MorskiWloczykij/STM32-DSP/Project Outputs for STM32_DSP/STM32_DSP.xlsx

Name | Description | Designator | Quantity | Manufacturer Part Number | Manufacturer
470p 50V | Capacitor: ceramic; MLCC; 470pF; 50V; X7R; ±10%; SMD; 0805 | C1, C8, C16, C24 | 4 | C0805C471K5RAC | KEMET
10u 25V | Capacitor: ceramic; MLCC; 10uF; 25V; X5R; ±10%; SMD; 0805 | C2, C7, C73, C74, C76, C82, C84, C86, C88, C90, C91, C92, C93 | 13 | GRM21BR61E106KA73K | MURATA
2.7n 50V | Capacitor: ceramic; MLCC; 2.7nF; 50V; X7R; ±10%; SMD; 0805 | C3, C6 | 2 | 08055C272KAT2A | KYOCERA AVX
1u 10V | Capacitor: ceramic; MLCC; 1uF; 10V; X7R; ±10%; SMD; 0805 | C4, C29, C30, C37, C38, C57 | 6 | CC0805KKX7R6BB105 | YAGEO
100n 100V | Capacitor: ceramic; MLCC; 100nF; 100V; X7R; ±10%; SMD; 0805 | C5, C10, C12, C14, C23, C32, C35, C36, C39, C60, C61, C62, C63, C64, C65, C66, C67, C68, C69, C70, C71, C72, C75, C77, C79, C81, C83, C85, C87, C89, C94 | 31 | CC0805KKX7R0BB104 | YAGEO
22u 10V | Capacitor: ceramic; 22uF; 10V; X5R; ±20%; SMD; 0805 | C9, C11, C13, C17, C19, C21, C25, C27, C33, C34, C78, C80 | 12 | CL21A226MPQNNNE | SAMSUNG
2.2n 50V | Capacitor: ceramic; MLCC; 2.2nF; 50V; X7R; ±10%; SMD; 0805 | C15, C22 | 2 | 08055C222KAT2A | KYOCERA AVX
6.8n 50V | Capacitor: ceramic; MLCC; 6.8nF; 50V; X7R; ±10%; SMD; 0805 | C18, C26 | 2 | 08055C682KAT2A | KYOCERA AVX
1.5n 50V | Capacitor: ceramic; MLCC; 1.5nF; 50V; X7R; ±10%; SMD; 0805 | C20, C28 | 2 | 08055C152KAT2A | KYOCERA AVX
20p 50V | Capacitor: ceramic; MLCC; 20pF; 50V; C0G (NP0); ±5%; SMD; 0805 | C40, C41, C42, C43 | 4 | 08055A200JAT2A | KYOCERA AVX
6.8p 50V | Capacitor: ceramic; MLCC; 6.8pF; 50V; C0G (NP0); ±0.25pF; SMD; 0805 | C44, C45 | 2 | CC0805CRNPO96R8 | YAGEO
1u 20V | Capacitor: tantalum; 1uF; 20VDC; SMD; A; 1206; ±10%; -55÷125°C; T491 | C46, C48 | 2 | T491A105K020AT | KEMET
100n 10V | Capacitor: ceramic; MLCC; 100nF; 100V; X7R; ±10%; SMD; 0805 | C47, C49, C50, C51, C52, C53, C54, C55, C56 | 9 | CC0805KKX7R0BB104 | YAGEO
2.2u 10V | Multilayer Ceramic Capacitors MLCC - SMD/SMT 0603 16VDC 1uF 10% X7R | C58, C59 | 2 | CC0805KKX7R6BB225 | YAGEO
3.3V | Diode: TVS; 134W; 5V; 11.2A; unidirectional; SOD523F; reel,tape | D1, D2, D3 | 3 | ESD5Z3V3 | DIOTEC SEMICONDUCTOR
Green |  | D4, D5, D6, D7 | 4 | - | -
12V | Zener Diodes 12 Volt 0.5W 5% | D8 | 1 | BZT55C12 | Vishay Semiconductors
Green | Standard LEDs - SMD WL-SMCW SMDMono TpVw Waterclr 0805 Green | D9 | 1 | 150080GS75000 | Wurth Elektronik
JC-211 | Socket; Jack 6,3mm; female; mono; ways: 2; for panel mounting; THT | J1, J2, J3, J4 | 4 | JC-211 | NINIGI
10 PIN | Pin header; pin strips; male; PIN: 10; straight; 1.27mm; THT; 2x5 | J5 | 1 | DS1031-06-2*5P8BV41-3A | CONNFLY
USB4105 | Socket; USB C; SMT; PIN: 16; horizontal; top board mount; USB 2.0 | J6 | 1 | USB4105-GF-A | GCT
PJ-002A | DC Power Connectors Power Jacks | J7 | 1 | PJ-002A | https://pl.mouser.com/datasheet/2/670/pj_002a-1778764.pdf
2 PIN | Headers & Wire Housings 2.54MM CGRIDIII HDR 2P VERT SR SEL AU | J8 | 1 | 90120-0762 | Molex
2700R | Ferrite: bead; 2700Ω; SMD; 200mA; 0805; -55÷125°C | L1, L4, L5, L6, L7, L8, L9, L10 | 8 | BLM21BD272SN1L | MURATA
150mΩ | Inductor: ferrite; SMD; 0805; 2.2uH; 1A; 150mΩ; 2MHz; ±20%; -40÷125°C | L2, L3 | 2 | MLP2012H2R2MT0S1 | TDK
100k | Trimmer Resistors - Through Hole 1/4"SQ 100KOHMS 10% 0.5WATTS | POT1, POT2 | 2 | 3362P-1-104LF | Bourns
100k | Potentiometers 100K 20% 9MM CARBON POT | POT3, POT4, POT5, POT6, POT7, POT8 | 6 | PTV09A-4020U-B104 | Bourns
1k | Trimmer Resistors - SMD TRIMMER-3MM OPEN FRAME | POT9, POT10 | 2 | TC33X-1-102E | Bourns
560R | Resistor: thick film; SMD; 0805; 560Ω; 0.125W; ±1%; -55÷155°C | R1, R9, R10, R17, R21, R29, R50, R51, R58, R59 | 10 | RC0805FR-07560R | Yageo
33R | Resistor: thick film; SMD; 0805; 33Ω; 0.125W; ±1%; -55÷155°C | R2, R4, R13, R14, R40, R42, R43, R45, R46, R47, R49, R69, R70 | 13 | RC0805FR-0733R | Yageo
100R | Resistor: thick film; SMD; 0805; 100Ω; 0.125W; ±1%; -55÷155°C | R3, R15, R73 | 3 | RC0805FR-07100R | Yageo
2.2M | Resistor: thick film; SMD; 0805; 2.2MΩ; 0.125W; ±5%; -55÷155°C | R5, R11 | 2 | RC0805JR-072M2 | Yageo
10k | Resistor: thick film; SMD; 0805; 10kΩ; 0.125W; ±1%; -55÷155°C | R6, R7, R12, R16, R35, R36, R37, R38, R54, R55, R62, R63, R64, R65, R66, R67, R68 | 17 | RC0805FR-0710K | Yageo
220R | Resistor: thick film; SMD; 0805; 220Ω; 0.125W; ±1%; -55÷155°C | R8 | 1 | RC0805FR-07220R | Yageo
4.7k | Resistor: thick film; SMD; 0805; 4.7kΩ; 0.125W; ±1%; -55÷155°C | R18, R26, R41, R44, R48, R71, R72 | 7 | RC0805FR-074K7 | Yageo
3.9k | Resistor: thick film; SMD; 0805; 3.9kkΩ; 0.125W; ±1%; -55÷155°C | R19, R27 | 2 | RC0805FR-073K9 | Yageo
2.2k | Resistor: thick film; SMD; 0805; 2.2kΩ; 0.125W; ±1%; -55÷155°C | R20, R28, R52, R53, R56, R57, R60, R61 | 8 | RC0805FR-072K2 | Yageo
1.2k | Resistor: thick film; SMD; 0805; 1.2kΩ; 0.125W; ±1%; -55÷155°C | R22, R30 | 2 | RC0805FR-071K2 | Yageo
680R | Resistor: thick film; SMD; 0805; 680Ω; 0.125W; ±1%; -55÷155°C | R23, R31 | 2 | RC0805FR-07680R | Yageo
1.5k | Resistor: thick film; SMD; 0805; 1.5kΩ; 0.125W; ±1%; -55÷155°C | R24, R32 | 2 | RC0805FR-071K5 | Yageo
47k | Resistor: thick film; SMD; 0805; 47kΩ; 0.125W; ±1%; -55÷155°C | R25, R33 | 2 | RC0805FR-0747K | Yageo
47R | Resistor: thick film; SMD; 0805; 47Ω; 0.125W; ±1%; -55÷155°C | R39 | 1 | RC0805FR-0747R | Yageo
6x6mm | Tactile Switches 6 x 6 mm, 5 mm Act Height, 260 gf, Black, Short Crimped, Through Hole, SPST | S1, S2, S4, S5 | 4 | TS02-66-50-BK-260-SCR-D | CUI Devices
BC847BLT1G | Bipolar Transistors - BJT 100mA 50V NPN | T1, T2, T3, T4 | 4 | BC847BLT1G | onsemi
1mm | Tesp Point 1mm | TP1, TP3, TP4, TP5, TP6, TP9, TP11, TP12, TP13, TP14, TP15, TP16, TP17, TP18, TP19, TP20, TP21, TP22, TP23, TP24, TP25, TP26, TP28, TP30, TP31, TP32, TP33, TP34, TP35, TP36, TP37, TP38, TP39, TP40, TP41, TP42, TP43, TP44, TP45, TP46, TP47, TP48, TP49, TP50, TP51, TP69, TP70, TP71, TP72, TP73, TP74, TP77, TP78, TP79, TP80 | 55 | - | -
AS321KTR | IC: operational amplifier; 3÷36V; Ch: 1; SOT23-5; reel,tape | U1, U2, U3, U4, U7, U8, U9 | 7 | AS321KTR-G1 | DIODES INCORPORATED
CS4271 | Interface - CODECs Stereo Audio CODEC 108 dB 192 kHz | U5 | 1 | CS4271-CZZ | Cirrus Logic
STM32F407VGT6 | IC: ARM microcontroller; 168MHz; LQFP100; 1.8÷3.6VDC | U6 | 1 | STM32F407VGT6 | STMicroelectronics
LM1117 | LDO Voltage Regulators 800MA LDO LINEAR REG | U10, U11 | 2 | LM1117DT-ADJ | Texas Instruments
ICL7660S | Switching Voltage Regulators ICL7660SCBA | U12 | 1 | ICL7660SCBAZ-T | Renesas / Intersil
8MHz | Crystals CRYSTAL 8.0000MHZ 20PF SMD | X1, X2 | 2 | ABLS-8.000MHZ-20-B-3-H-T | ABRACON
32.768kHz | Resonator: watch; 32.768kHz; ±20ppm; SMD; 8x3.2x2.38mm | X3 | 1 | MC306 32.768000KHZ 12.5PF | EPSON
