MorskiWloczykij/STM32-DSP/Project Outputs for STM32_DSP/STM32_DSP.PDF

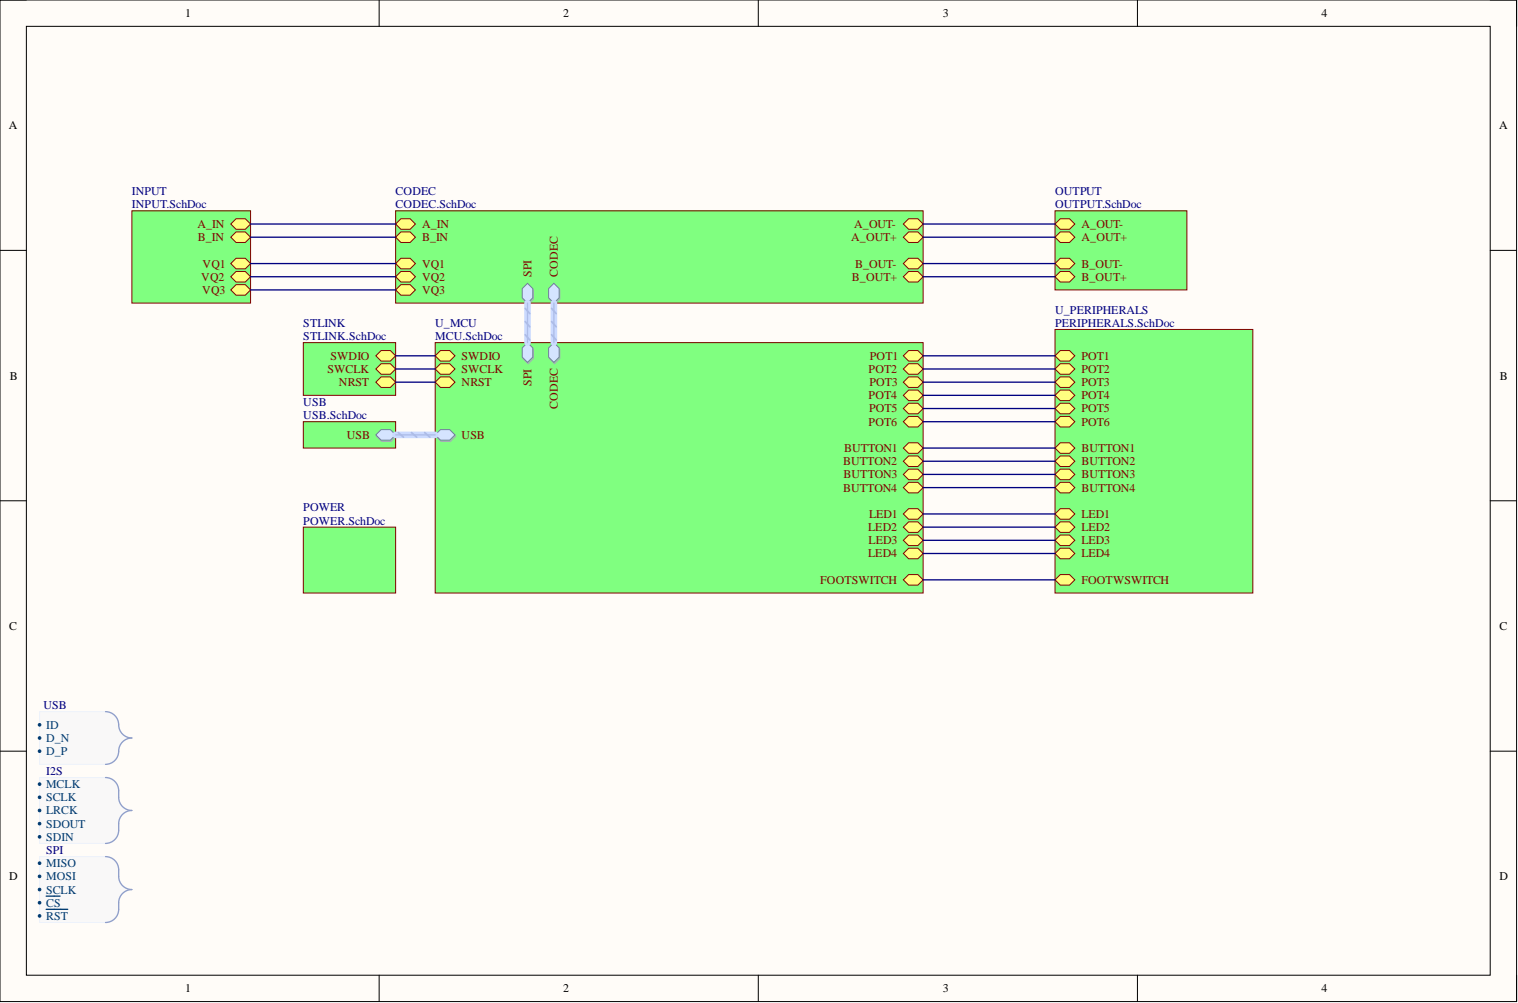
[picture p1: page 1]

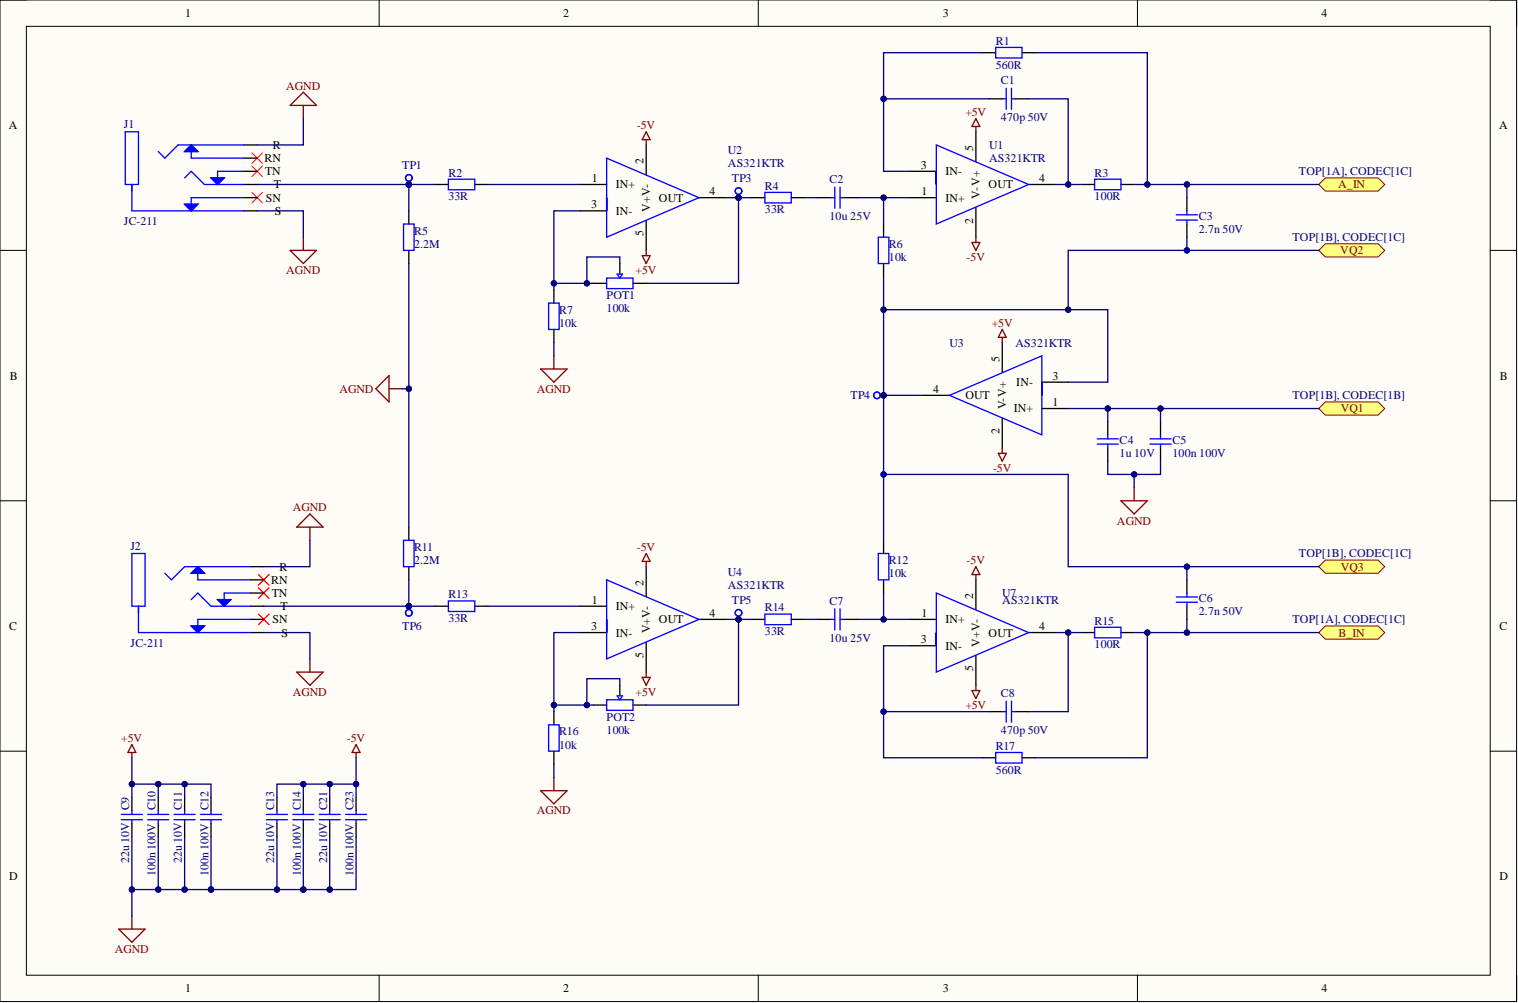
[picture p2: page 2]

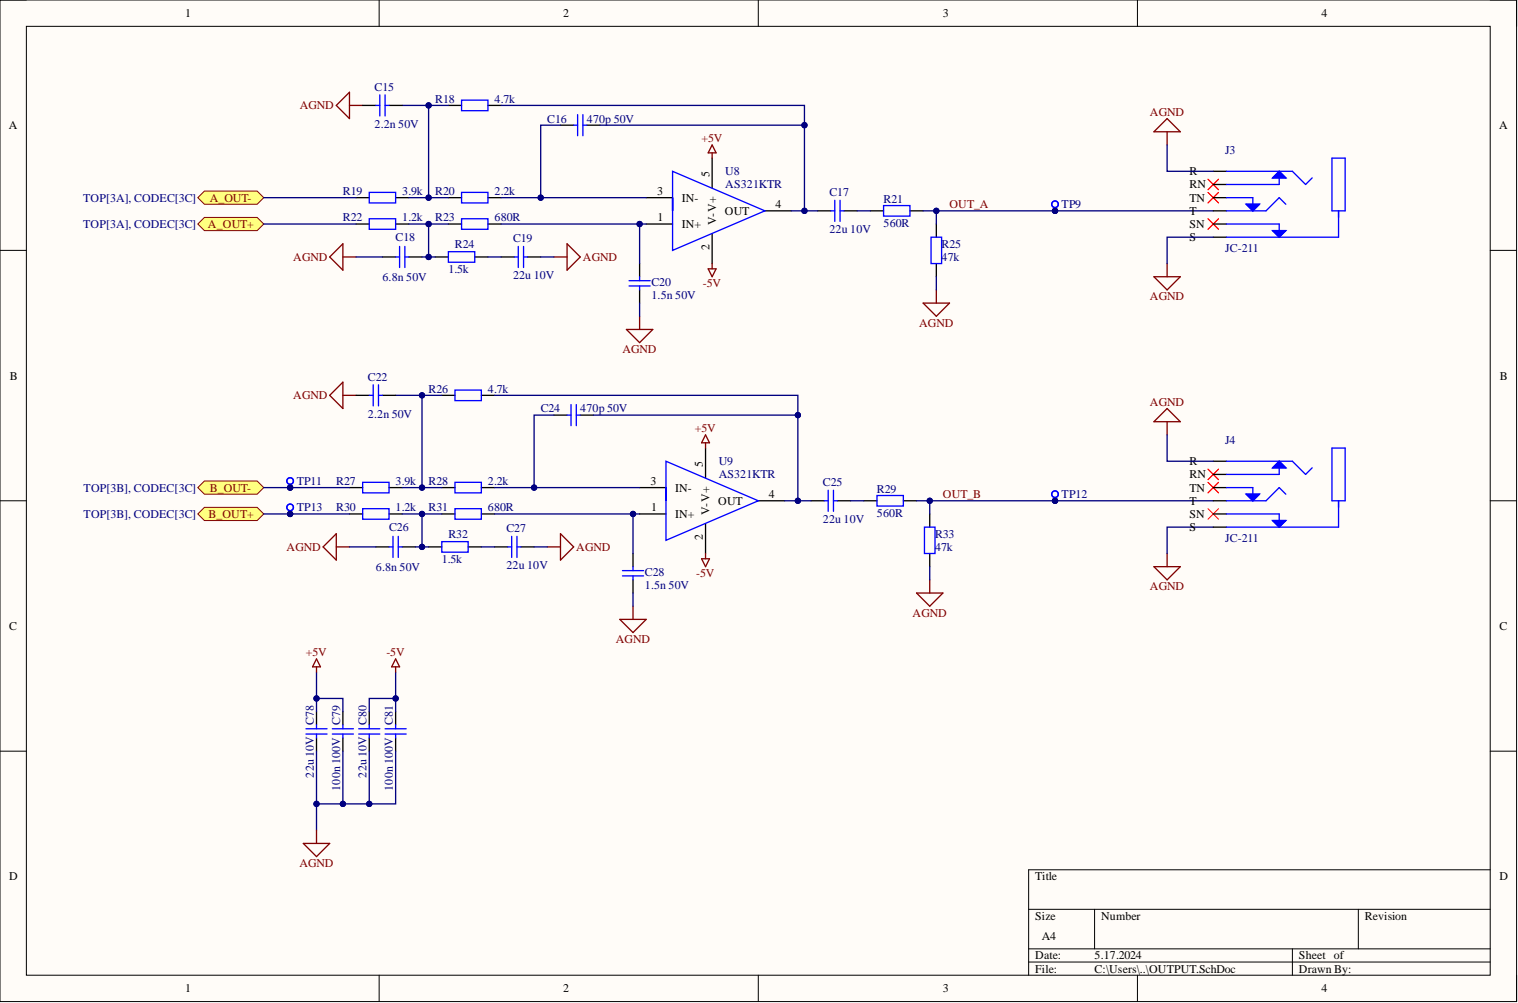
[picture p3: page 3]

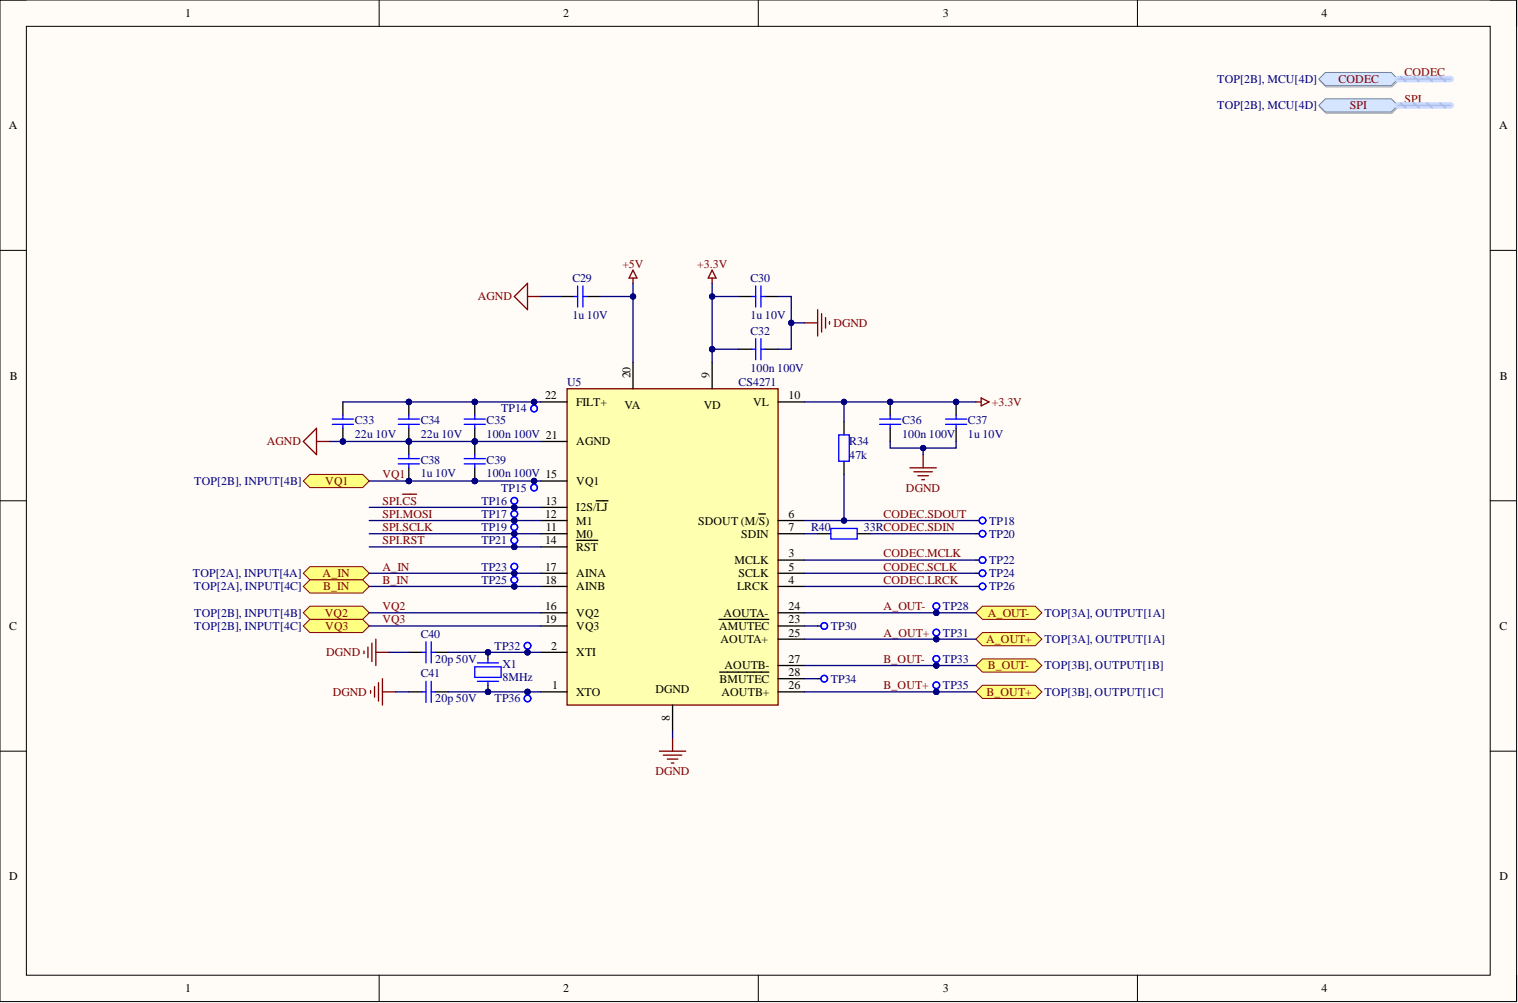
[picture p4: page 4]

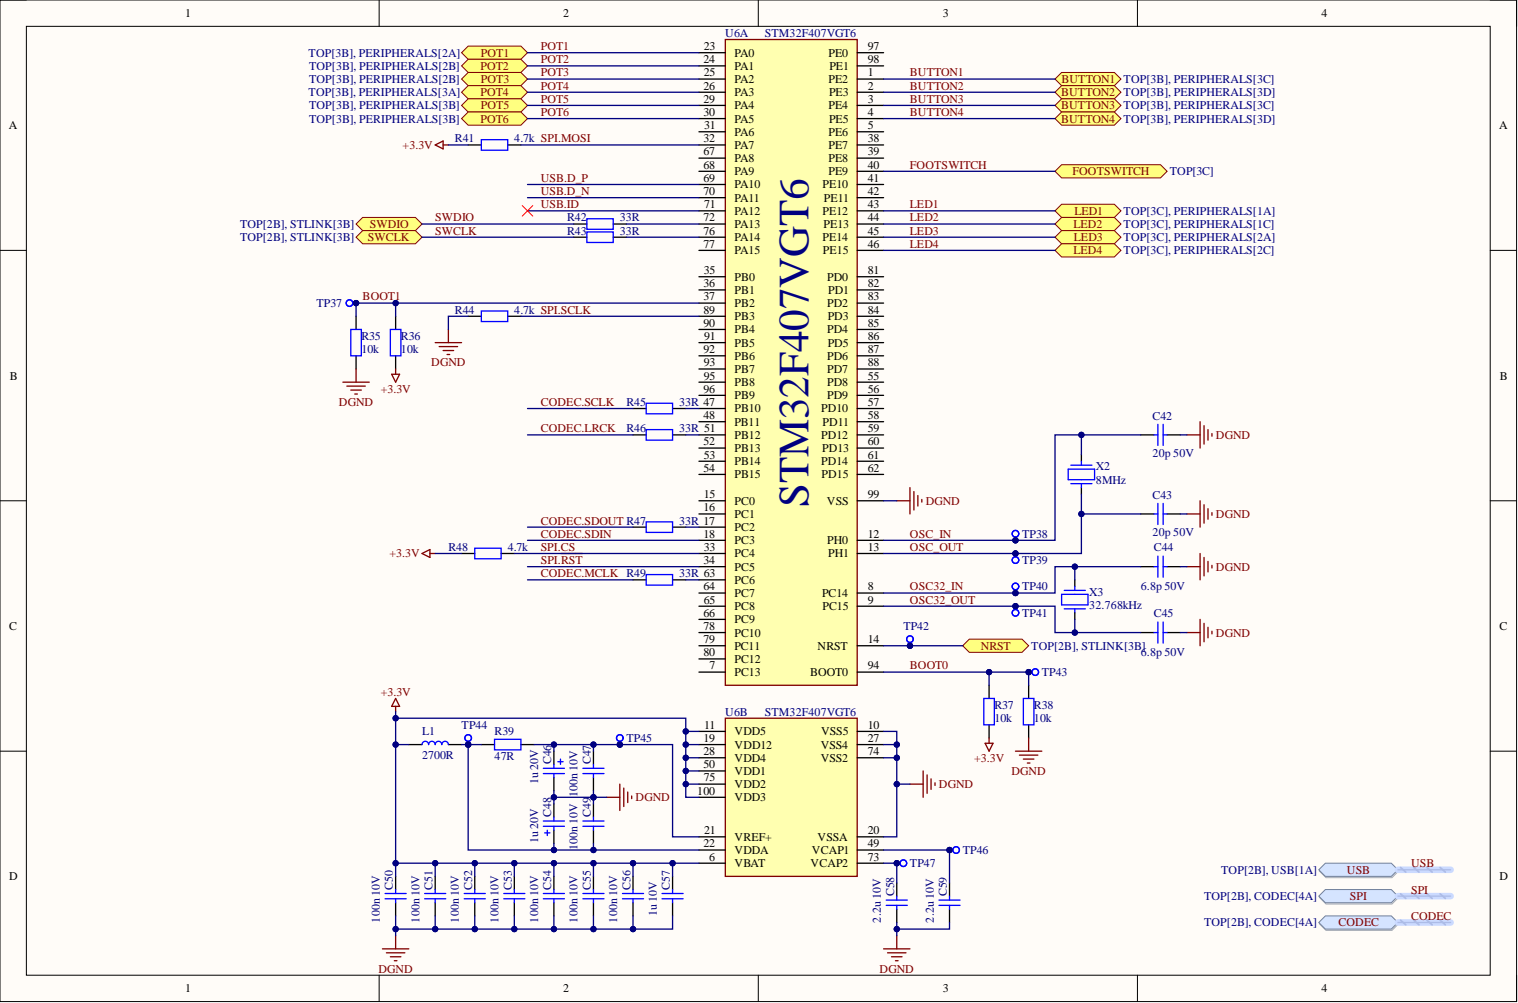
[picture p5: page 5]

8 9
9 0

1 9 | | 2 7
2 8 | 7 4
5 0 | | 2 0
7 5
1 0 0

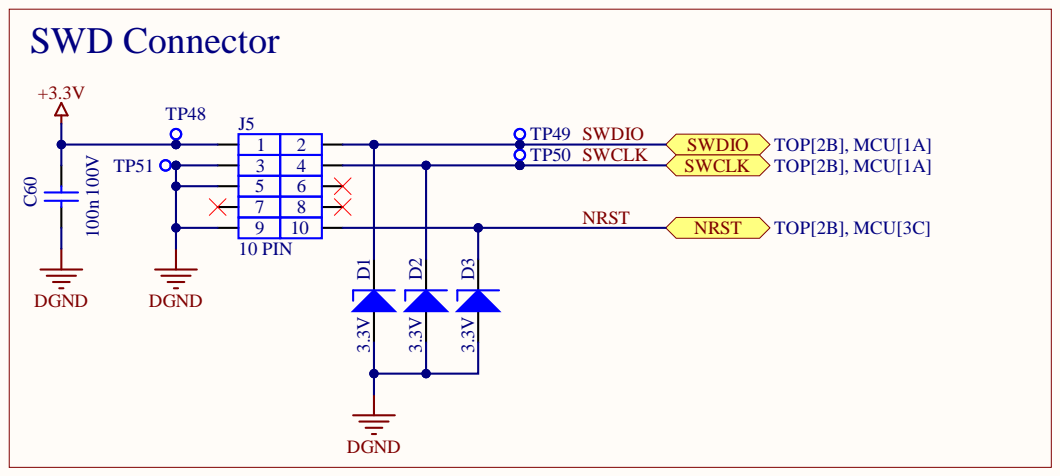
[picture p6: page 6]

9 | 1 0

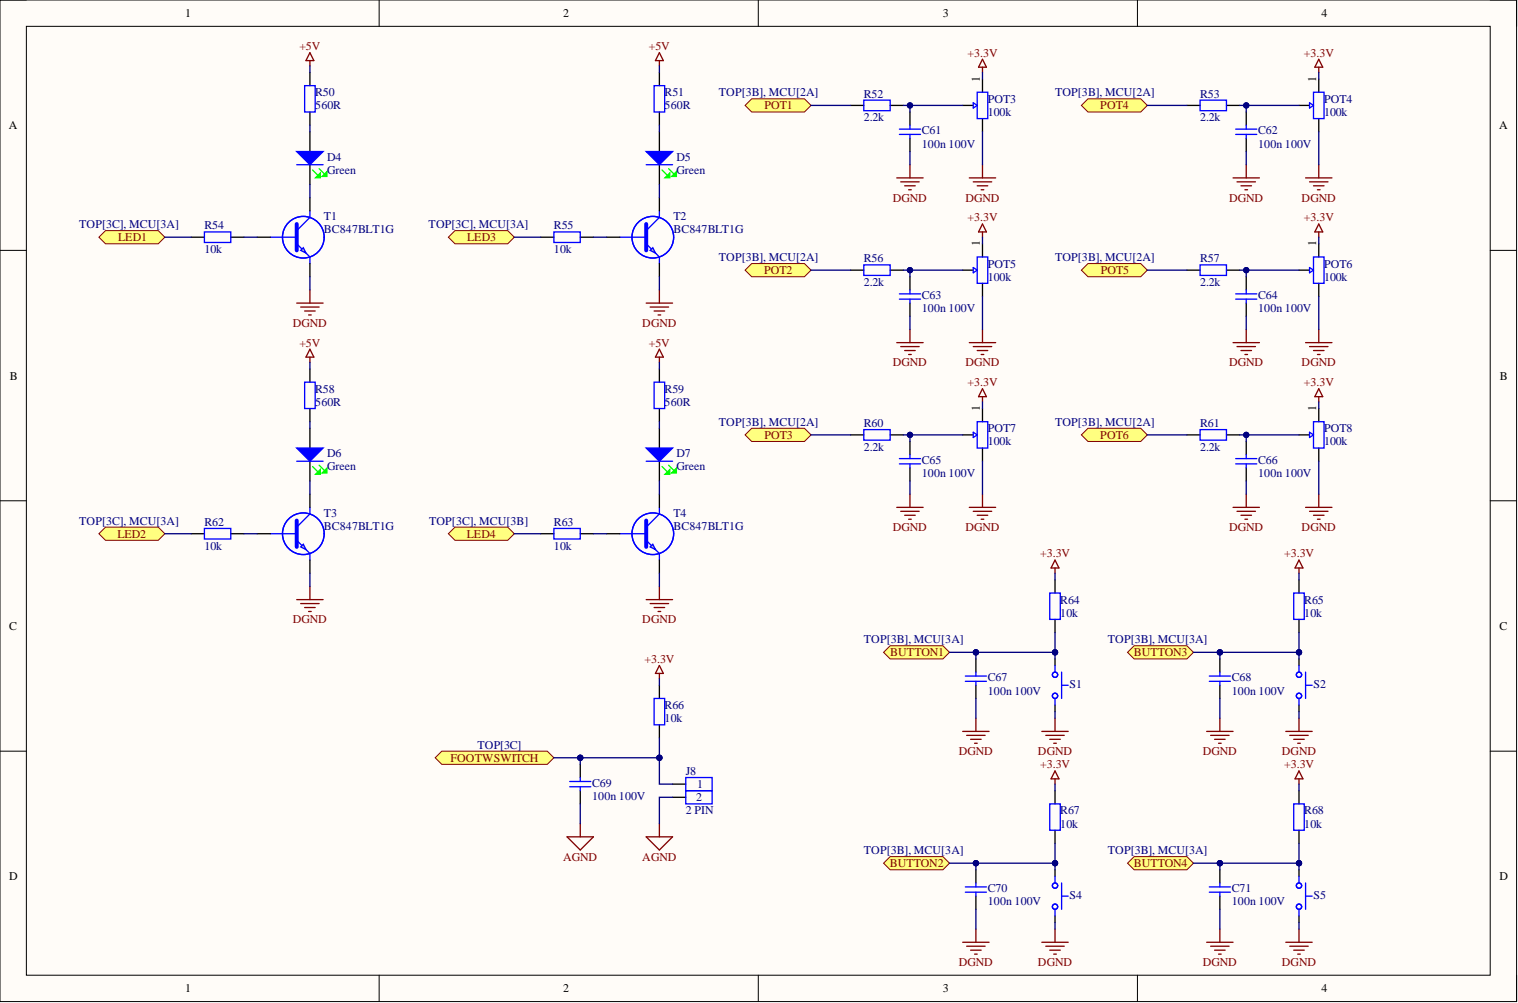
[picture p7: page 7]

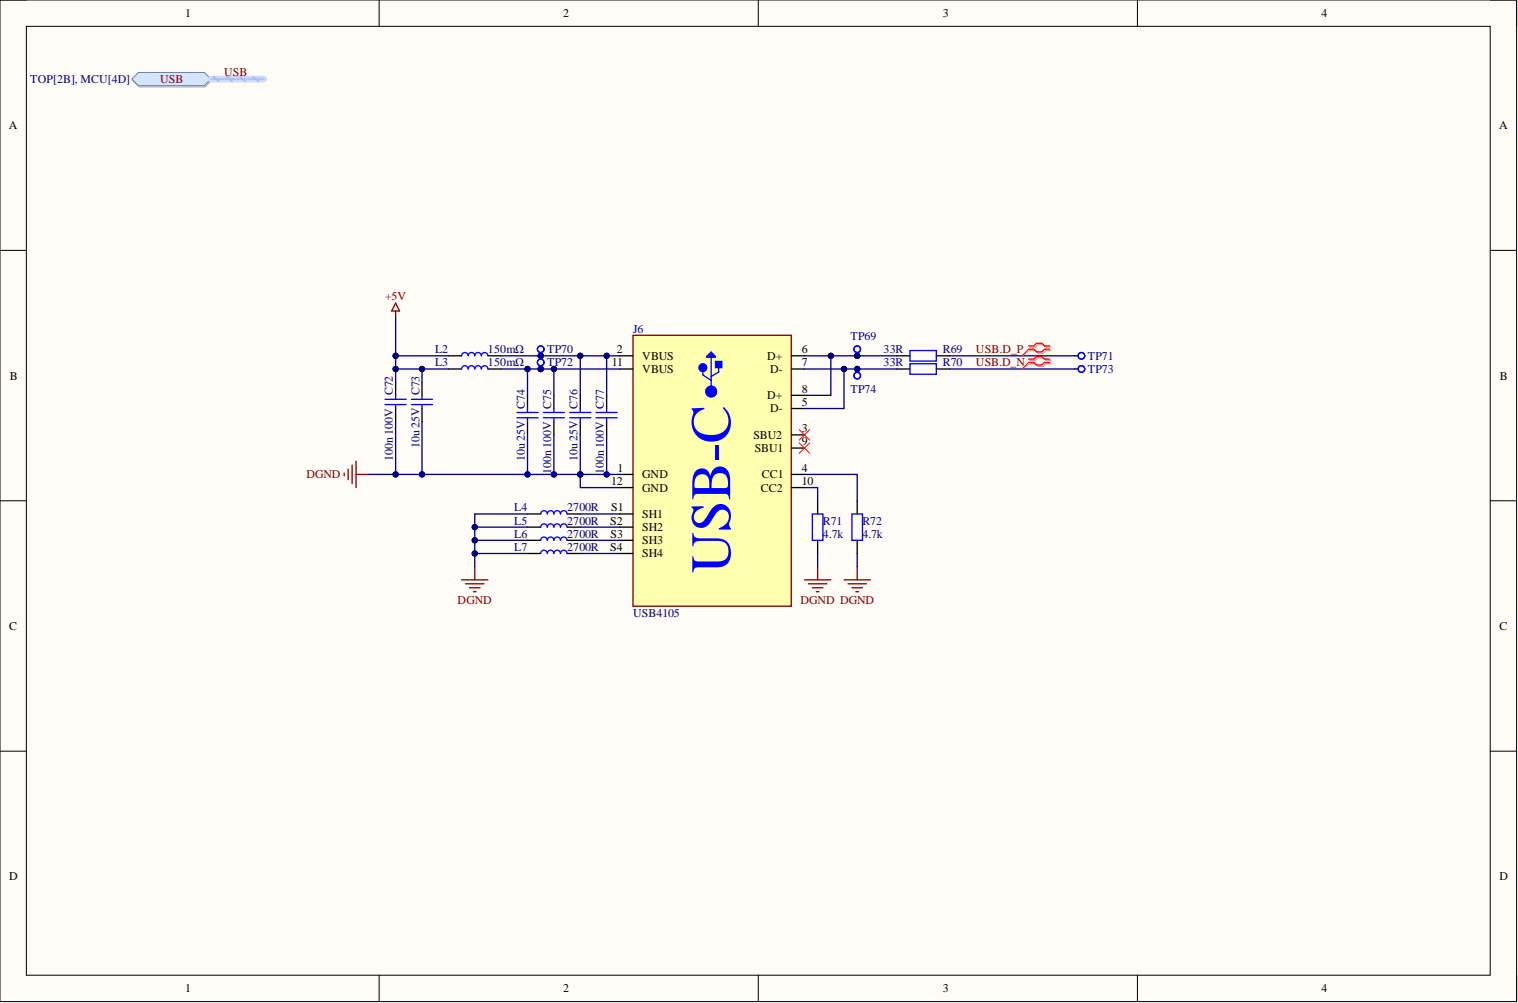
[picture p8: page 8]

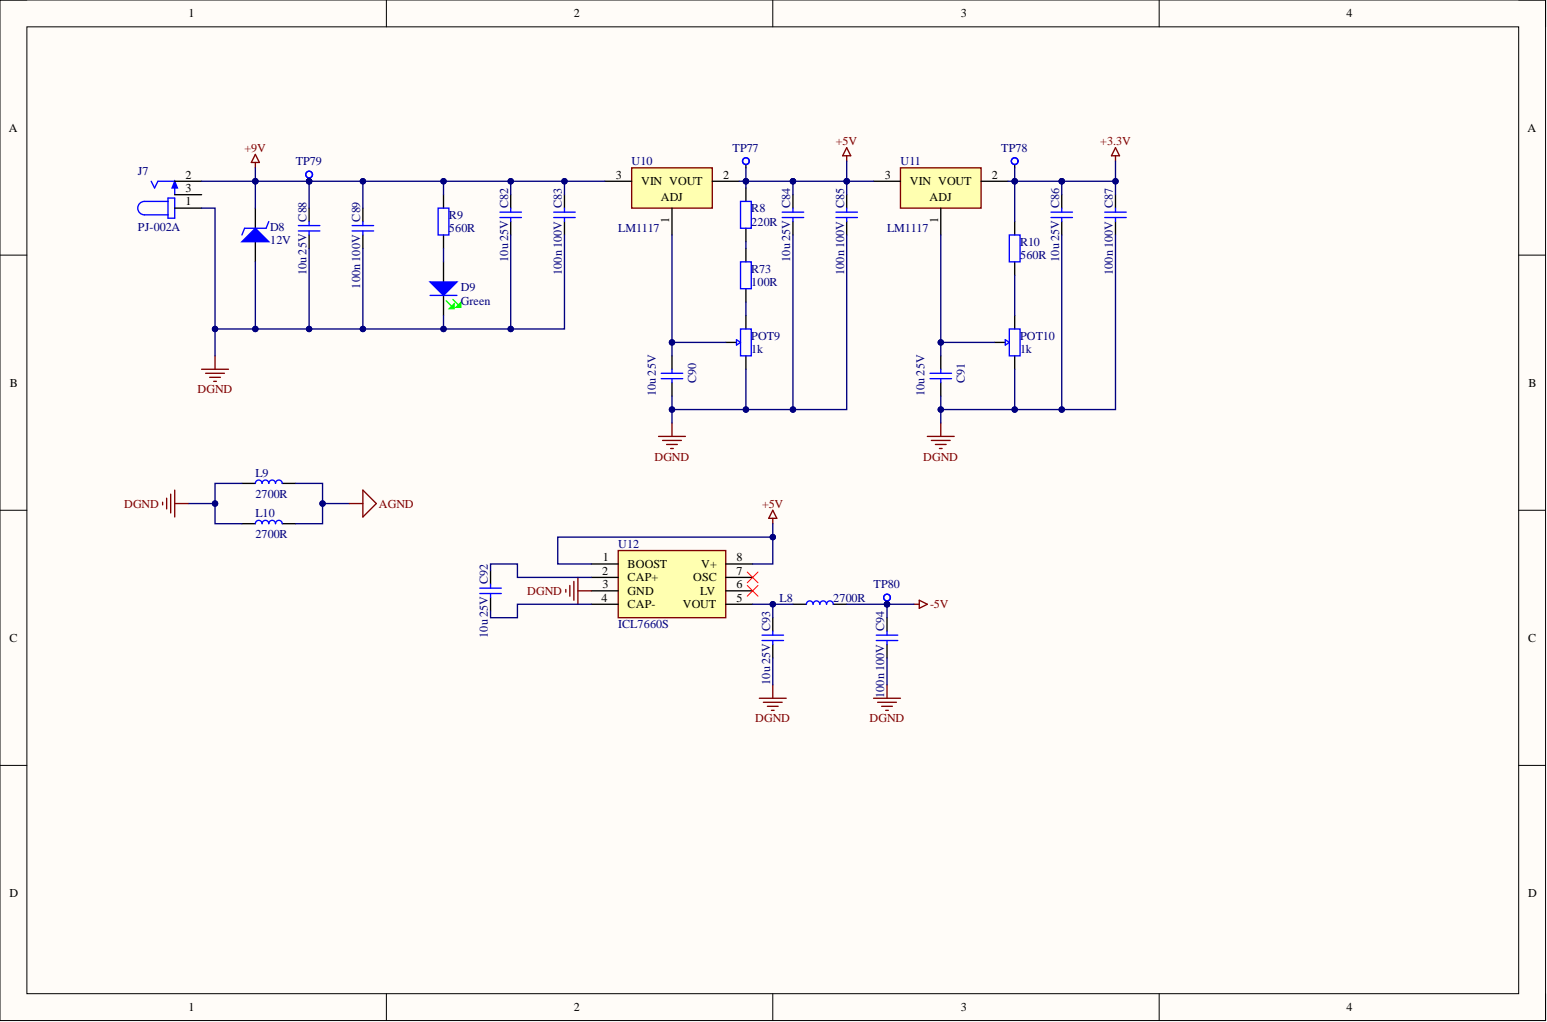
[picture p9: page 9]
