MorskiWloczykij/STM32-DSP/Input_Buffer.asc

C1: cap; 10µ
C2: cap; 470p
C3: cap; 2.7n
R1: res; 2.2Meg
R2: res; 33
R3: res; 10k
R4: res; 10k
R5: res; 100k
R6: res; 560
R7: res; 100k
R8: res; 100k
R9: res; 33
R10: res; 91
R11: res; 470k
U1: OP07
U2: OP07
V1: voltage; SINE(0 100m 1k); AC 1
V2: voltage; 9
V3: voltage; 9
Named nets: 0, V+, V-, Bias
.ac dec 1000 1 100k
