MorskiWloczykij/STM32-DSP/Output_Buffer.asc

C1: cap; 22µ
C2: cap; 6.8n
C3: cap; 1.5n
C4: cap; 470p
C5: cap; 2.2n
C6: cap; 22µ
R1: res; 3.9k
R2: res; 2.2k
R3: res; 680
R4: res; 1.5k
R5: res; 4.7k
R6: res; 560
R7: res; 1.2k
R8: res; 47k
U3: OP07
V1: voltage; SINE(2.5 1.25 1k); AC 1
V2: voltage; 9
V3: voltage; 9
V4: voltage; SINE(2.5 1.25 1k 0 0 180); AC 1
Named nets: V+, V-, 0
.tran 0 10m 0 1u
