MorskiWloczykij/STM32-DSP/(list of files, drawings)

Other design files:
CODEC.SchDoc
INPUT.SchDoc
MCU.SchDoc
OUTPUT.SchDoc
PERIPHERALS.SchDoc
POWER.SchDoc
STLINK.SchDoc
STM32_DSP.PrjPcb
TOP.SchDoc
USB.SchDoc
